ghozalihadi/boxembedded/Code/AWS/API gateway/API gateway list.PNG

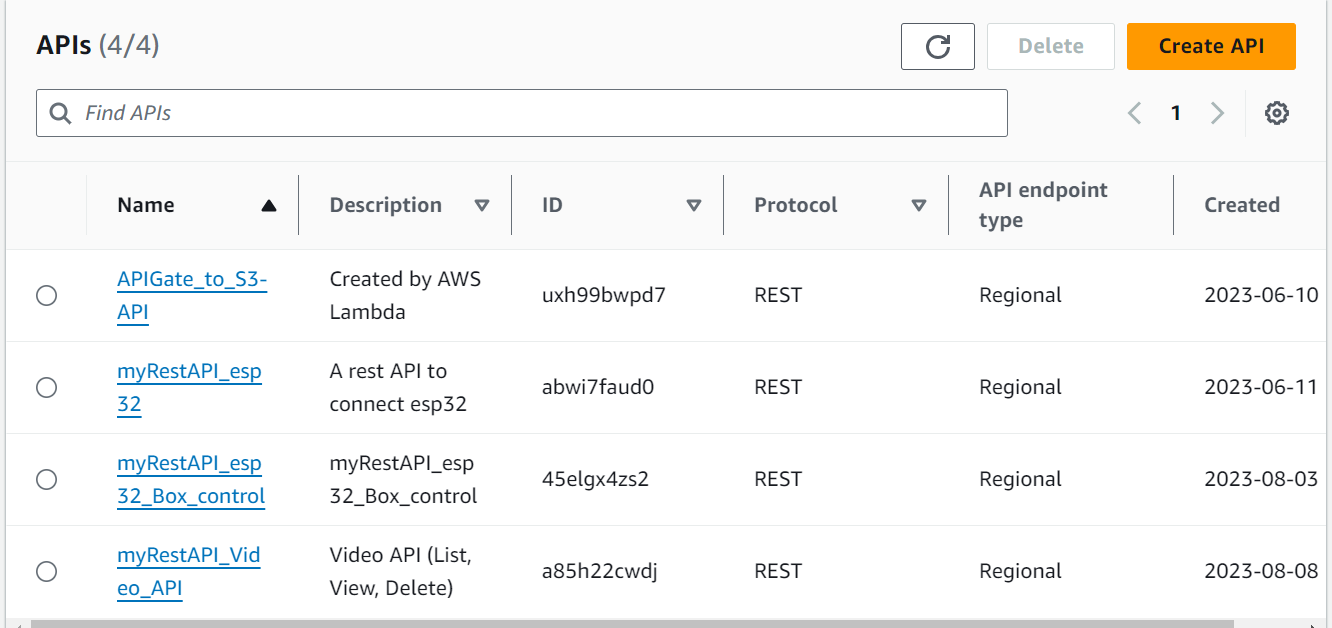
Code/AWS/API gateway/API gateway list.PNG
