ghozalihadi/boxembedded/Code/AWS/Kinesis Video Streams/kvs-camera-01.png

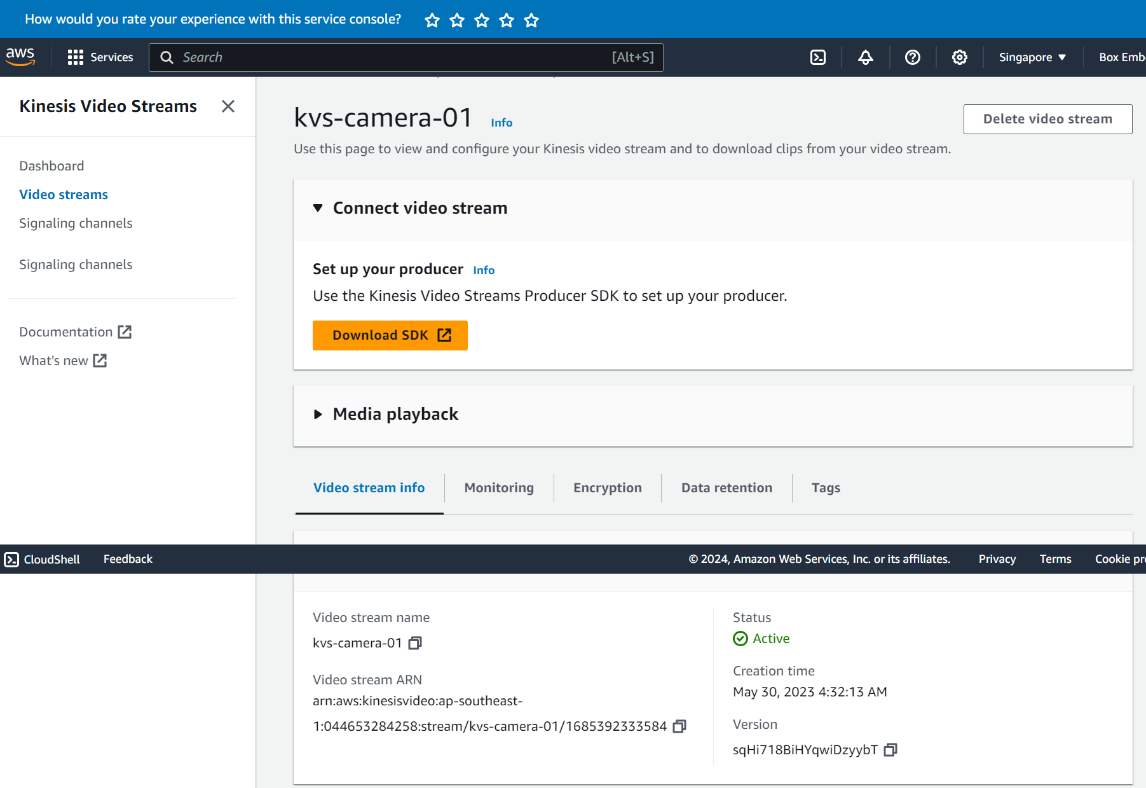
Code/AWS/Kinesis Video Streams/kvs-camera-01.png
