ghozalihadi/boxembedded/(list of files, drawings)

Other design files:
Hardware/PCB design/MainBoard_Box.PrjPcb
Hardware/PCB design/MainBoard_Box.SchDoc
