ghozalihadi/boxembedded/Hardware/Components Integration/How to integrate main components.docx

In general, this document wants to elaborate step-by-step to integrate other components (camera, keypad, etc) with our main board by soldering connectors and wiring

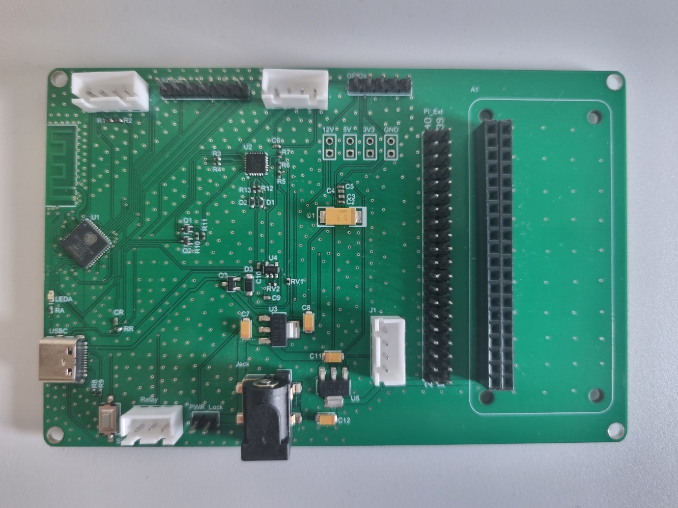
[picture p6: figure]
