ghozalihadi/boxembedded/Code/ESP32/test/AWS_Get_json.cpp

/*
  Rui Santos
  Complete project details at Complete project details at https://RandomNerdTutorials.com/esp32-http-get-post-arduino/
  
  Modified for AWS API Gateway by Stephen Borsay teaching AWS IoT on Udemy.com

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
  The above copyright notice and this permission notice shall be included in all
  copies or substantial portions of the Software.
*/

#include <Arduino.h>
#include "WiFi.h"
#include "U8g2lib.h"
#include "Wire.h"
#include <HTTPClient.h>
#include <WiFiManager.h>
#include <Arduino_JSON.h>

#include "soc/soc.h"
#include "soc/rtc_cntl_reg.h"


const char* ssid = "15-624";
const char* password = "ZavieraElsaftyHadi";

//Your Domain name with URL path or IP address with path
String serverName = "https://boxembeddedbucket.s3.ap-southeast-1.amazonaws.com/ESP32datastream/ESP32_control.json";
const char* API_KEY = "0nAjSAnXF250jkBug7fGF56b6mF45j5f5kGP3Ekd"; //Your AWS API-Key

// the following variables are unsigned longs because the time, measured in
// milliseconds, will quickly become a bigger number than can be stored in an int.
unsigned long lastTime = 0;
// Timer set to 10 minutes (600000)
//unsigned long timerDelay = 600000;
// Set timer to 5 seconds (5000)
unsigned long timerDelay = 10000;
unsigned long Uptime;

String sensorReadings;
float sensorReadingsArr[3];

void setup() {
  Serial.begin(115200); 

  WiFi.begin(ssid, password);
  Serial.println("Connecting");
  while(WiFi.status() != WL_CONNECTED) {
    delay(500);
    Serial.print(".");
  }
  Serial.println("");
  Serial.print("Connected to WiFi network with IP Address: ");
  Serial.println(WiFi.localIP());
 
  Serial.println("Timer set to 10 seconds (timerDelay variable), it will take 10 seconds before publishing the first reading.");
}

void loop() {

  int t =  random(30,110); //fake number range, adjust as you like
  int h =  random(50,100);

  Uptime = millis()/1000;
  
  //Send an HTTP POST request every 10 minutes
  if ((millis() - lastTime) > timerDelay) {
    //Check WiFi connection status
    if(WiFi.status()== WL_CONNECTED){
      HTTPClient http;
      
      // Your Domain name with URL path or IP address with path
      http.begin(serverName);
      ////http.begin(serverPath.c_str());
      //http.addHeader("x-api-key", API_KEY); 
      http.addHeader("Content-Type", "application/json");

      // Send HTTP GET request
      String payload = "{}";
      int httpResponseCode = http.GET();
      
      if (httpResponseCode>0) {
        Serial.print("HTTP Response code: ");
        Serial.println(httpResponseCode);
        payload = http.getString();
        Serial.println(payload);

        ////////////////////
        sensorReadings = payload;
        JSONVar myObject = JSON.parse(sensorReadings);
  
        // JSON.typeof(jsonVar) can be used to get the type of the var
        //if (JSON.typeof(myObject) == "undefined") {
        //  Serial.println("Parsing input failed!");
        //  return;
        //}
      
        Serial.print("JSON object = ");
        Serial.println(myObject);
      
        // myObject.keys() can be used to get an array of all the keys in the object
        JSONVar keys = myObject.keys();
    
        for (int i = 0; i < keys.length(); i++) {
          const char* value = myObject[keys[i]];
          Serial.print(keys[i]);
          Serial.print(" = ");
          Serial.println(atoi(value));
        }
        /////////////////////

      }
      else {
        Serial.print("Error code: ");
        Serial.println(httpResponseCode);
      }
      // Free resources
      http.end();
    }
    else {
      Serial.println("WiFi Disconnected");
    }
    lastTime = millis();
  }
}
