ghozalihadi/boxembedded/(commit log)

2024-02-05 add video instruction
    [BOM_MainBoard_Box.csv, MainBoard_Box.PrjPcb, MainBoard_Box.SchDoc, Pick Place for MainBoard_Box.csv]
2024-02-05 add raspberry pi and AWS code
